celalkutluer/XbeeArduinoThermostat/README.md

# XbeeArduinoThermostat
Xbee modüller kullanılarak oluşturulmuş bir thermostat uygulaması

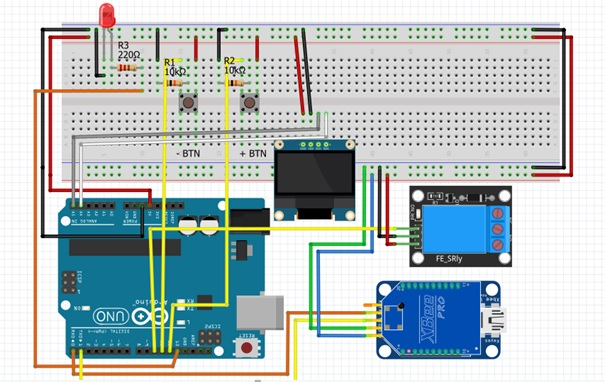
[picture p1: circuit_diagram/coordinator_arduino.jpg]
CoordinatorArduino

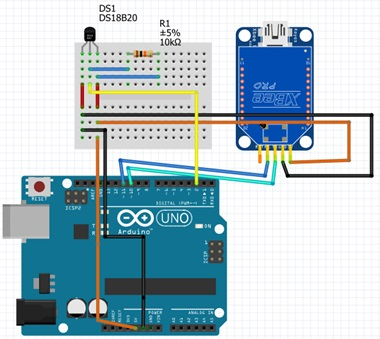
[picture p2: circuit_diagram/rooter_arduino.jpg]
RouterArduino

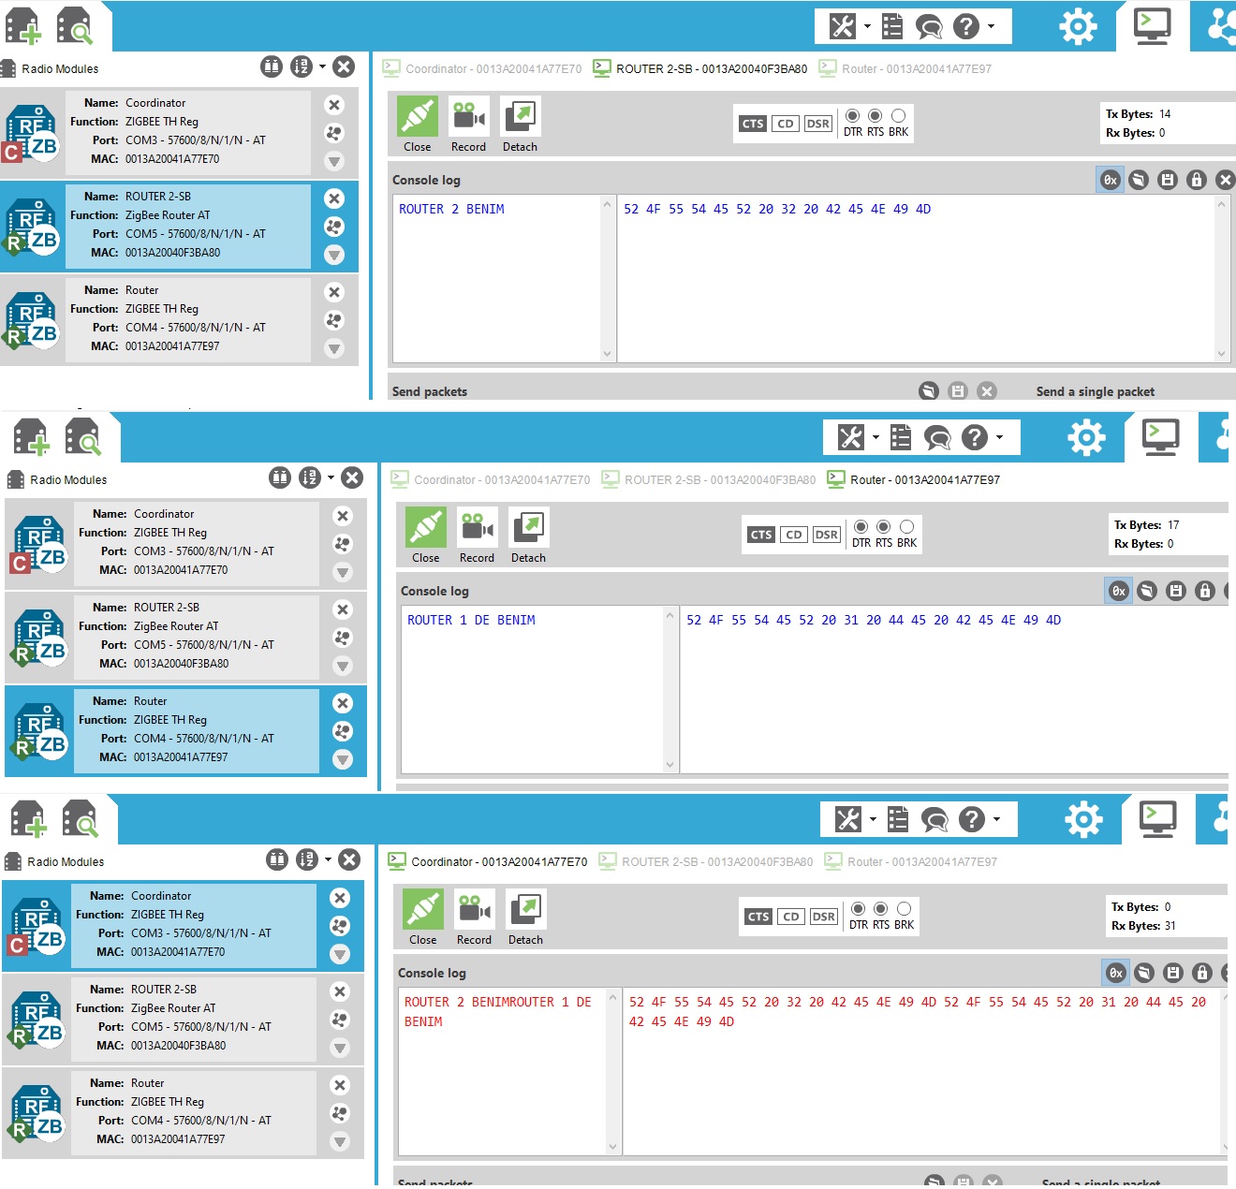
[picture p3: circuit_diagram/xbee_data.jpg]
Xbee Data Message

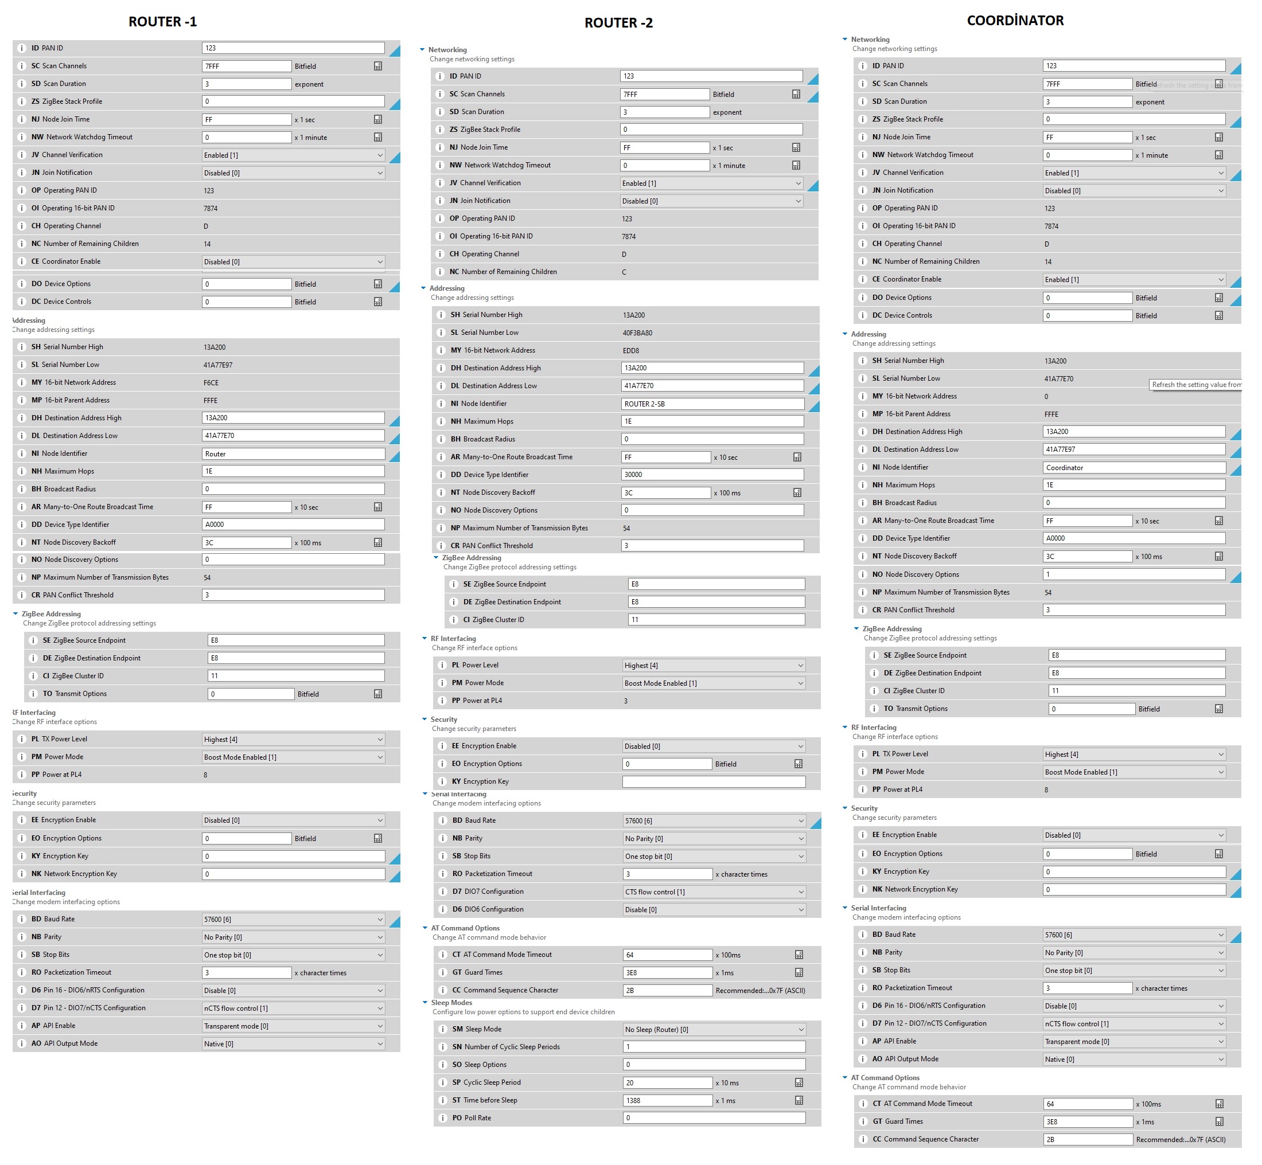
[picture p4: circuit_diagram/xbee_settings.jpg]
Xbee Coordinator and Router Settings
