celalkutluer/XbeeArduinoThermostat/(commit log)

2021-03-28 Add files via upload
    arduino alıcı ve verici kodları
2021-04-19 master
    add project circuit diagrams and xbee settings
